dimitrit/65uino/hardware/65uino.kicad_pcb

## KiCad design hardware/65uino.kicad_pcb (2025-01-10)

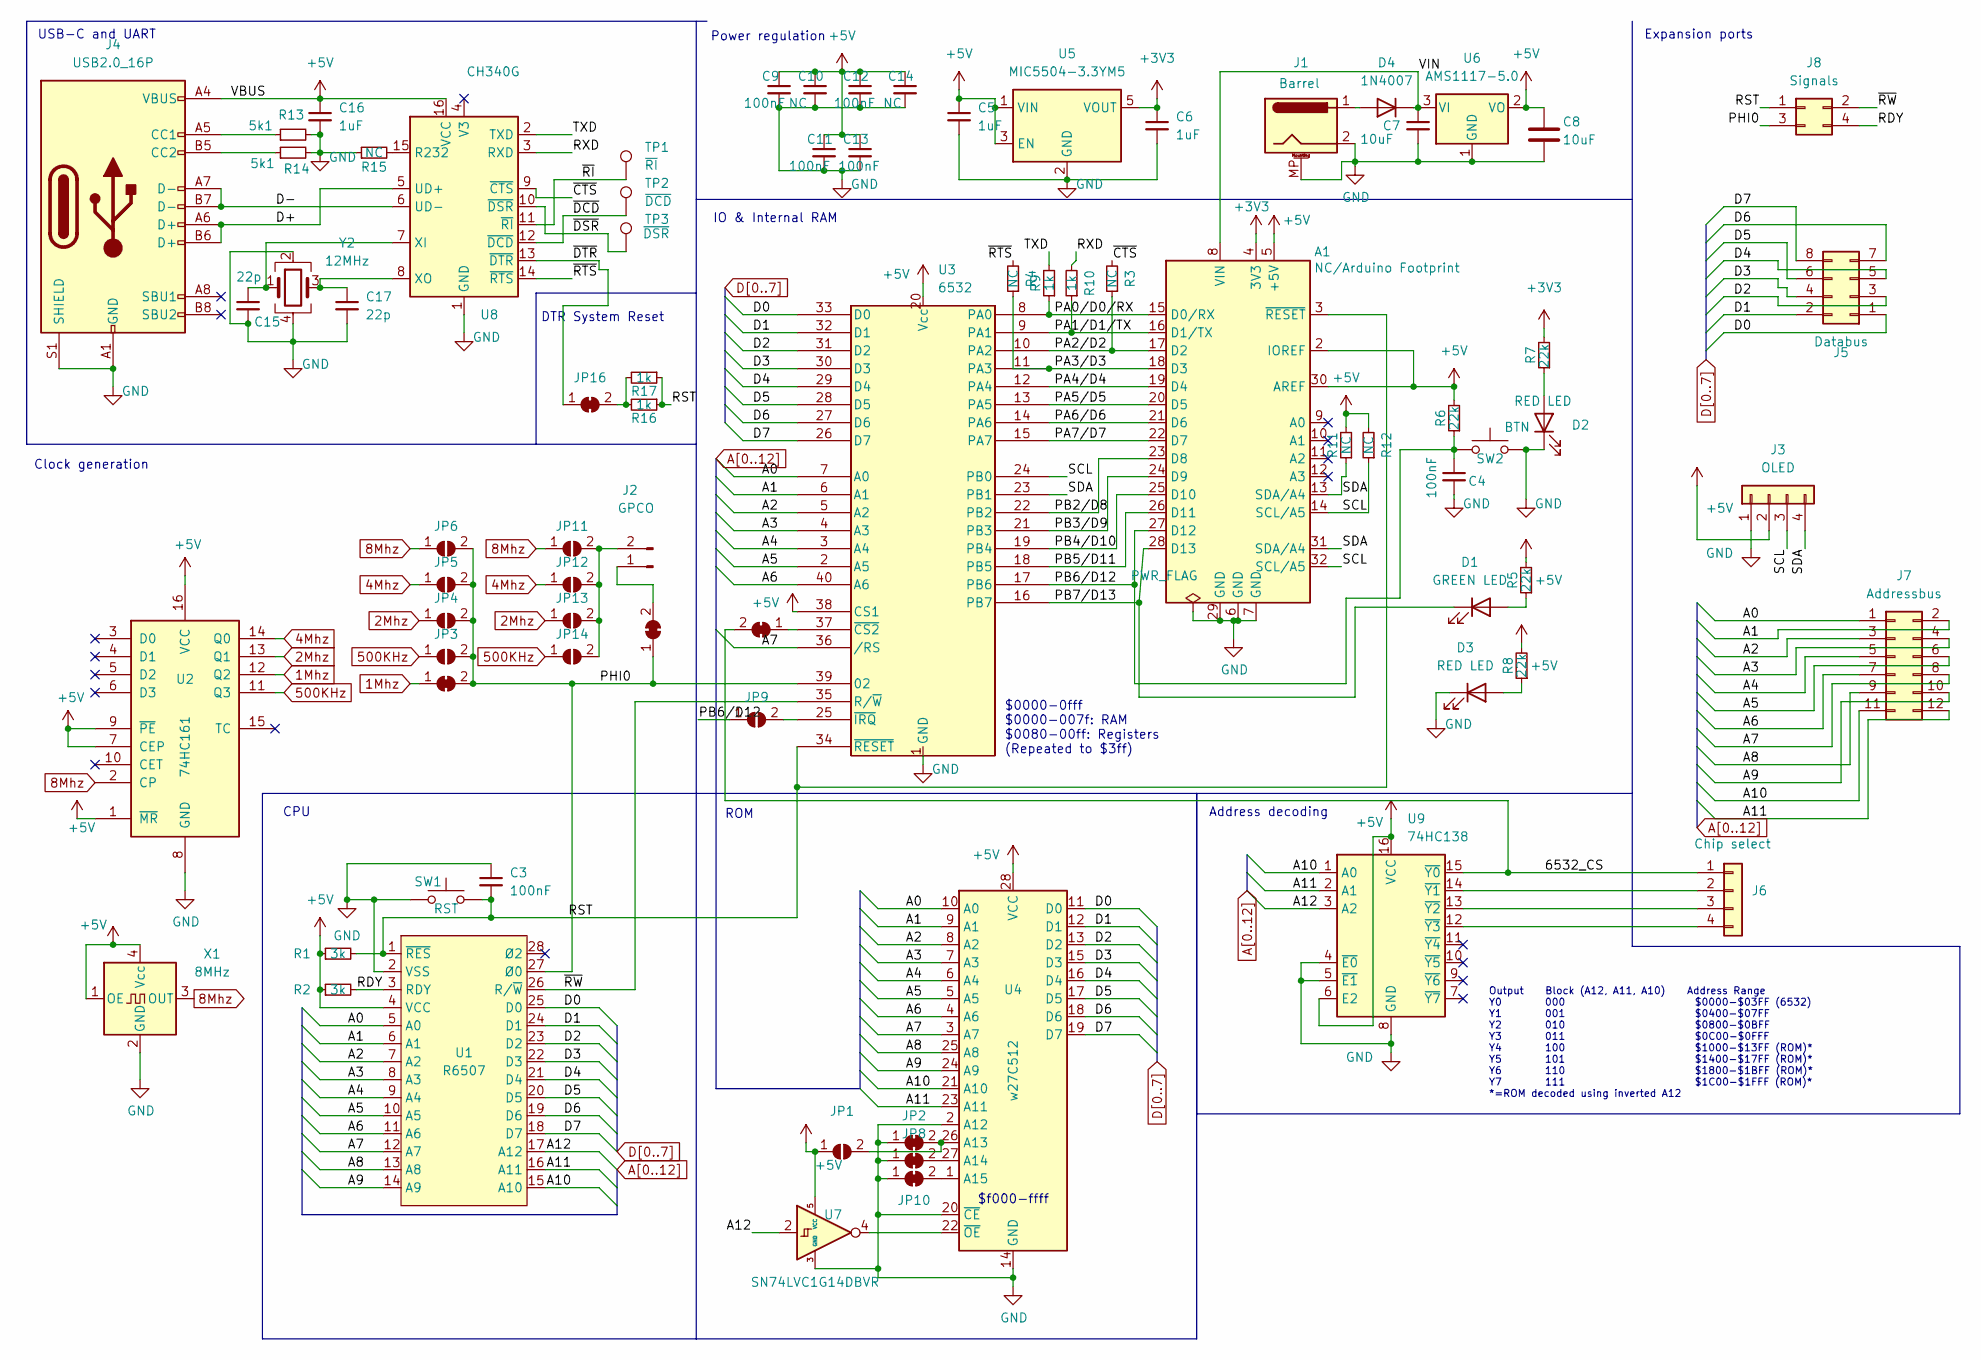
[picture p1: schematic 65uino.kicad_sch]

Parts:
A1: NC/Arduino Footprint; Arduino_UNO_R3_WithMountingHoles
C3, C4, C9, C11, C12, C13: 100nF; C_0805_2012Metric; LCSC C49678
C5, C6, C16: 1uF; C_0805_2012Metric; LCSC C28323
C7, C8: 10uF; C_1206_3216Metric; LCSC C13585
C10, C14: NC; C_0805_2012Metric
C15, C17: 22p; C_0805_2012Metric
D1: GREEN LED; LED_0805_2012Metric; LCSC C2297
D2, D3: RED LED; LED_0805_2012Metric; LCSC C84256
D4: 1N4007; D_SMA; LCSC C95872
J1: Barrel; BarrelJack_Horizontal
J2: GPCO; PinHeader_1x02_P2.54mm_Vertical
J3: OLED; PinSocket_1x04_P2.54mm_Vertical
J4: USB2.0_16P; USB_C_Receptacle_HCTL_HC-TYPE-C-16P-01A; LCSC C2894897
J5: Databus; PinHeader_2x04_P2.54mm_Vertical
J6: Chip select; PinSocket_1x04_P2.54mm_Vertical
J7: Addressbus; PinHeader_2x06_P2.54mm_Vertical
J8: Signals; PinHeader_2x02_P2.54mm_Vertical
JP1: SolderJumper_2_Open; SolderJumper-2_P1.3mm_Open_RoundedPad1.0x1.5mm
JP2, JP7, JP8, JP10, JP15, JP16, JP17: SolderJumper_2_Bridged; SolderJumper-2_P1.3mm_Bridged_RoundedPad1.0x1.5mm
JP3, JP4, JP5, JP6, JP9, JP11, JP12, JP13, JP14: SolderJumper_2_Bridged; SolderJumper-2_P1.3mm_Open_RoundedPad1.0x1.5mm
R1, R2: 3k; R_0805_2012Metric; LCSC C17661
R3, R4, R11, R12, R15: NC; R_0805_2012Metric
R5, R6, R8: 22k; R_0805_2012Metric; LCSC C17560
R7: 22k; R_0805_2012Metric; LCSC C17475
R9, R10, R16, R17: 1k; R_0805_2012Metric
R13, R14: 5k1; R_0805_2012Metric
SW1: RST; SW_SPST_TL3342; LCSC C318884
SW2: BTN; SW_SPST_TL3342; LCSC C318884
TP1: ~{RI}; TestPoint_Pad_D1.0mm
TP2: ~{DCD}; TestPoint_Pad_D1.0mm
TP3: ~{DSR}; TestPoint_Pad_D1.0mm
U1: R6507; DIP-28_W15.24mm; LCSC C72121
U2: 74HC161; SOP-16_3.9x9.9mm_P1.27mm; LCSC C5310798
U3: 6532; DIP-40_W15.24mm; LCSC C72123
U4: w27C512; DIP-28_W15.24mm; LCSC C72121
U5: MIC5504-3.3YM5; SOT-23-5; LCSC C3021093
U6: AMS1117-5.0; SOT-223-3_TabPin2; LCSC C347223
U7: SN74LVC1G14DBVR; SOT-23-5; LCSC C434069
U8: CH340G; SOIC-16_3.9x9.9mm_P1.27mm; LCSC C14267
U9: 74HC138; SOP-16_3.9x9.9mm_P1.27mm; LCSC C2906780
X1: 8MHz; Crystal_SMD_3225-4Pin_3.2x2.5mm; LCSC C454610
Y2: 12MHz; Crystal_SMD_3225-4Pin_3.2x2.5mm; LCSC C133334

Connections:
1Mhz: JP7.1 (A), U2.12 (Q2)
2Mhz: JP4.1 (A), JP13.1 (A), U2.13 (Q1)
4Mhz: JP5.1 (A), JP12.1 (A), U2.14 (Q0)
8Mhz: JP6.1 (A), JP11.1 (A), U2.2 (CP), X1.3 (OUT)
500KHz: JP3.1 (A), JP14.1 (A), U2.11 (Q3)
+3V3: A1.4 (3V3), C6.1, R7.2, U5.5 (VOUT)
+5V: A1.2 (IOREF), A1.5 (+5V), A1.30 (AREF), C5.1, C8.1, C9.1, C10.1, C11.1, C12.1, C13.1, C14.1, C16.1, J3.2, J4.A4 (VBUS), J4.A9 (VBUS), J4.B4 (VBUS), J4.B9 (VBUS), JP1.1 (A), R1.1, R2.1, R5.2, R6.2, R8.2, R11.2, R12.2, U1.4 (VCC), U2.1 (~MR), U2.7 (CEP), U2.9 (~PE), U2.16 (VCC), U3.20 (Vcc), U3.38 (CS1), U4.28 (VCC), U5.1 (VIN), U5.3 (EN), U6.2 (VO), U7.5 (VCC), U8.16 (VCC), U9.6 (E2), U9.16 (VCC), X1.1 (OE), X1.4 (Vcc)
/6532_CS: J6.1, JP17.2 (B), U9.15 (~Y0)
/D+: J4.A6 (D+), J4.B6 (D+), U8.5 (UD+)
/D-: J4.A7 (D-), J4.B7 (D-), U8.6 (UD-)
/PA0/D0/RX: A1.15 (D0/RX), R9.1, U3.8 (PA0)
/PA1/D1/TX: A1.16 (D1/TX), R10.1, U3.9 (PA1)
/PA2/D2: A1.17 (D2), R3.1, U3.10 (PA2)
/PA3/D3: A1.18 (D3), R4.1, U3.11 (PA3)
/PA4/D4: A1.19 (D4), U3.12 (PA4)
/PA5/D5: A1.20 (D5), U3.13 (PA5)
/PA6/D6: A1.21 (D6), U3.14 (PA6)
/PA7/D7: A1.22 (D7), U3.15 (PA7)
/PB2/D8: A1.23 (D8), U3.22 (PB2)
/PB3/D9: A1.24 (D9), U3.21 (PB3)
/PB4/D10: A1.25 (D10), U3.19 (PB4)
/PB5/D11: A1.26 (D11), U3.18 (PB5)
/PB6/D12: A1.27 (D12), C4.1, JP9.1 (A), R6.1, SW2.1, U3.17 (PB6)
/PB7/D13: A1.28 (D13), D1.1 (K), U3.16 (PB7)
/PHI0: J8.3, JP3.2 (B), JP4.2 (B), JP5.2 (B), JP6.2 (B), JP7.2 (B), JP15.1 (A), U1.27 (Ø0), U3.39 (02)
/RDY: J8.4, R2.2, U1.3 (RDY)
/RST: A1.3 (~RESET), C3.2, J8.1, R1.2, R16.1, R17.1, SW1.2, U1.1 (~RES), U3.34 (~RESET)
/RXD: R10.2, U8.3 (RXD)
/SCL: A1.14 (SCL/A5), A1.32 (SCL/A5), J3.3, R12.1, U3.24 (PB0)
/SDA: A1.13 (SDA/A4), A1.31 (SDA/A4), J3.4, R11.1, U3.23 (PB1)
/TXD: R9.2, U8.2 (TXD)
/VIN: A1.8 (VIN), C7.1, D4.1 (K), U6.3 (VI)
/~CTS: R3.2, U8.9 (~CTS)
/~DCD: TP2.1, U8.12 (~DCD)
/~DSR: TP3.1, U8.10 (~DSR)
/~DTR: JP16.1 (A), U8.13 (~DTR)
/~RI: TP1.1, U8.11 (~RI)
/~RTS: R4.2, U8.14 (~RTS)
/~RW: J8.2, U1.26 (R/~W), U3.35 (R/~W)
A0: J7.1, U1.5 (A0), U3.7 (A0), U4.10 (A0)
A1: J7.2, U1.6 (A1), U3.6 (A1), U4.9 (A1)
A2: J7.3, U1.7 (A2), U3.5 (A2), U4.8 (A2)
A3: J7.4, U1.8 (A3), U3.4 (A3), U4.7 (A3)
A4: J7.5, U1.9 (A4), U3.3 (A4), U4.6 (A4)
A5: J7.6, U1.10 (A5), U3.2 (A5), U4.5 (A5)
A6: J7.7, U1.11 (A6), U3.40 (A6), U4.4 (A6)
A7: J7.8, U1.12 (A7), U3.36 (/RS), U4.3 (A7)
A8: J7.9, U1.13 (A8), U4.25 (A8)
A9: J7.10, U1.14 (A9), U4.24 (A9)
A10: J7.11, U1.15 (A10), U4.21 (A10), U9.1 (A0)
A11: J7.12, U1.16 (A11), U4.23 (A11), U9.2 (A1)
A12: U1.17 (A12), U7.2, U9.3 (A2)
D0: J5.1, U1.25 (D0), U3.33 (D0), U4.11 (D0)
D1: J5.2, U1.24 (D1), U3.32 (D1), U4.12 (D1)
D2: J5.3, U1.23 (D2), U3.31 (D2), U4.13 (D2)
D3: J5.4, U1.22 (D3), U3.30 (D3), U4.15 (D3)
D4: J5.5, U1.21 (D4), U3.29 (D4), U4.16 (D4)
D5: J5.6, U1.20 (D5), U3.28 (D5), U4.17 (D5)
D6: J5.7, U1.19 (D6), U3.27 (D6), U4.18 (D6)
D7: J5.8, U1.18 (D7), U3.26 (D7), U4.19 (D7)
GND: A1.6 (GND), A1.7 (GND), A1.29 (GND), C3.1, C4.2, C5.2, C6.2, C7.2, C8.2, C9.2, C10.2, C11.2, C12.2, C13.2, C14.2, C15.2, C16.2, C17.2, D2.1 (K), D3.1 (K), J1.2, J1.MP (MountPin), J3.1, J4.A1 (GND), J4.A12 (GND), J4.B1 (GND), J4.B12 (GND), J4.S1 (SHIELD), JP2.1 (A), JP8.1 (A), JP10.1 (A), R13.2, R14.2, R15.1, SW1.1, SW2.2, U1.2 (VSS), U2.8 (GND), U3.1 (GND), U4.2 (A12), U4.14 (GND), U4.20 (~CE), U5.2 (GND), U6.1 (GND), U7.3 (GND), U8.1 (GND), U9.4 (~E0), U9.5 (~E1), U9.8 (GND), X1.2 (GND), Y2.2, Y2.4
unnamed: D1.2 (A), R5.1
unnamed: D2.2 (A), R7.1
unnamed: D3.2 (A), R8.1
unnamed: D4.2 (A), J1.1
unnamed: J2.1, JP15.2 (B)
unnamed: J2.2, JP11.2 (B), JP12.2 (B), JP13.2 (B), JP14.2 (B)
unnamed: J4.A5 (CC1), R13.1
unnamed: J4.B5 (CC2), R14.1
unnamed: J6.2, U9.14 (~Y1)
unnamed: J6.3, U9.13 (~Y2)
unnamed: J6.4, U9.12 (~Y3)
unnamed: JP1.2 (B), JP2.2 (B), U4.26 (A13)
unnamed: JP8.2 (B), U4.27 (A14)
unnamed: JP9.2 (B), U3.25 (~IRQ)
unnamed: JP10.2 (B), U4.1 (A15)
unnamed: JP16.2 (B), R16.2, R17.2
unnamed: JP17.1 (A), U3.37 (~CS2)
unnamed: U4.22 (~OE), U7.4
unnamed: R15.2, U8.15 (R232)
unnamed: C15.1, U8.7 (XI), Y2.1
unnamed: C17.1, U8.8 (XO), Y2.3

Notes on the sheet:
ROM
DTR System Reset
Clock generation
CPU
Expansion ports
IO & Internal RAM
$0000-0fff $0000-007f: RAM $0080-00ff: Registers (Repeated to $3ff)
$f000-ffff
Power regulation
Output Block (A12, A11, A10) Address Range Y0 000 $0000-$03FF (6532) Y1 001 $0400-$07FF Y2 010 $0800-$0BFF Y3 011 $0C00-$0FFF Y4 100 $1000-$13FF (ROM)* Y5 101 $1400-$17FF (ROM)* Y6 110 $1800-$1BFF (ROM)* Y7 111 $1C00-$1FFF (ROM)* *=ROM decoded using inverted A12
USB-C and UART
Address decoding

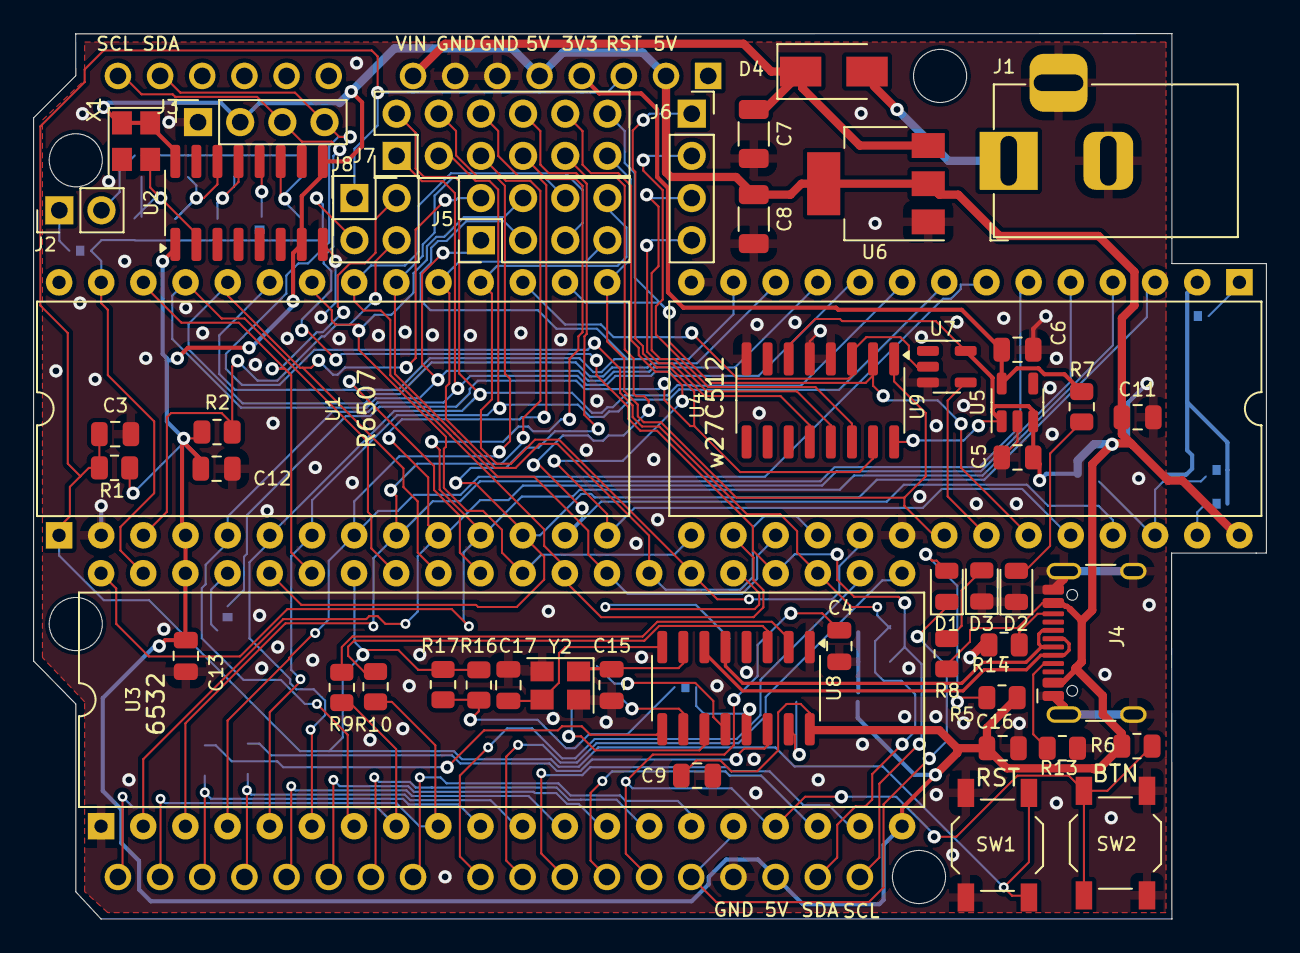
[picture p2: board 65uino.kicad_pcb from above]

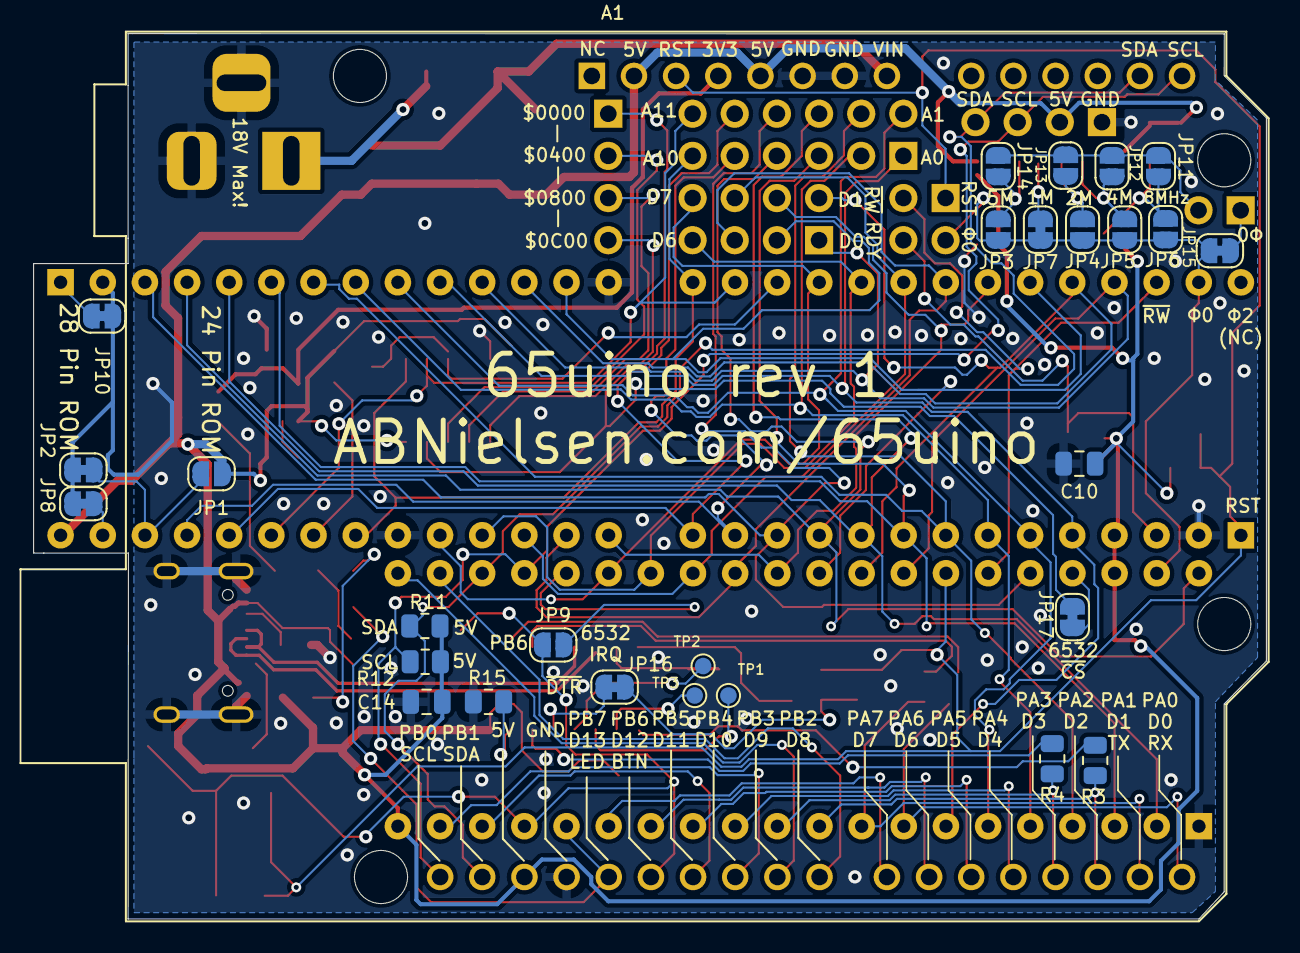
[picture p3: board 65uino.kicad_pcb from below]

Board: 2 copper layers, 74.3 x 53.3 mm, 78 parts (28 on the bottom side), 82 nets.
