dimitrit/65uino/(commit log)

2025-01-02 Move source files to dedicated directory
    [memmap.cfg]
2025-01-02 Initial Makefile
    [memmap.cfg]
2025-01-02 Split rom into modules
    [memmap.cfg]
