dimitrit/65uino/(notices)

Notices in the files:
hardware/65uino.kicad_pcb:
License: https://creativecommons.org/licenses/by-nc/4.0/legalcode
